zunda/arduino-thermostat/README.md

arduino-thermostat
==================

Trying to replace a broken Differential Temperature Thermostat DTT-94 with an Arduino

太陽熱温水器のサーモスタットが壊れたので代わりのものをつくる

壊れたもの
--------

Differential Temperature Thermostat DTT-94, Heliotrope General

温度計はSAS-10というもののようだ。パネルから温水が戻ってくる配管のタンクの近くにひとつとりつけられている。もうひとつはパネルにとりつけられているものと思われる。回路計では両方とも温度を検出しているような抵抗値を示していた。

温度計の仕様
----------

下記にSAS-10の温度(F)-抵抗のテーブルがある
* http://www.heliodyne.com/products_systems/control_units/SAS-10-RT.pdf
* http://www.heliodyne.com/products_systems/control_units/DeltaT.pdf

これを
[resistance-vs-temperature.xlsx](SAS-10/resistance-vs-temperature.xlsx)
にまとめた。
0℃から100℃までを測定しようとすると、32.65kΩから678.4Ωまでを測定する必要がある。

### 近似式
http://en.wikipedia.org/wiki/Thermistor#Steinhart.E2.80.93Hart_equation
より
```
t(r)=1/(a+b*log(r)+c*(log(r)**3))-273.16
```
ただしrは抵抗値(Ω)、tは温度(℃)。

[resistance-vs-temperature.plot](SAS-10/resistance-vs-temperature.plot)
で0-100℃の範囲を[フィット](SAS-10/fit.log)すると

| Parameter | Best fit (1/K) |
|---|---|
| a | 0.00112974 |
| b | 0.00023399 |
| c | 8.8342e-08 |

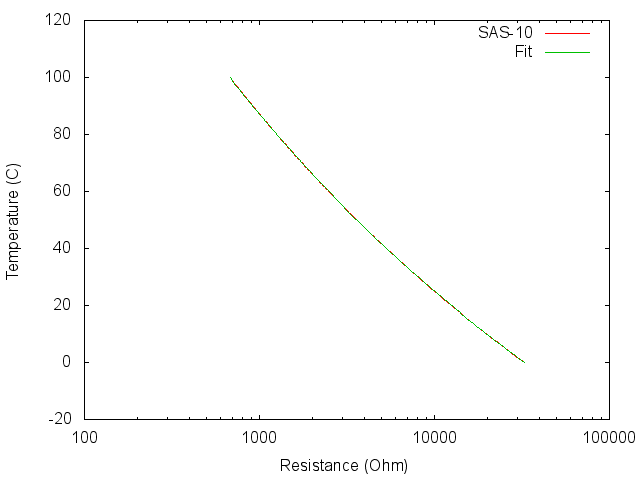
[picture p1: SAS-10/resistance-vs-temperature.png]
resistance-vs-temperature


Arduinoでの抵抗値の読み
--------------------
* `analogRead(pin)`は0から5ボルトの入力電圧を0から1023の数字に変換する
* `analogReference(type)`はアナログ入力で使われる基準電圧を設定する。
  * `DEFAULT`: 電源電圧(5V)
  * `INTERNAL`: 内蔵基準電圧(1.1V、2.56V)
  * `EXTERNAL`: AREFピンへの電圧(0-5V、32KΩでGNDへ)

* http://www.eleki-jack.com/FC/2011/09/arduino2-3.html
  温度計はGNDとアナログ入力の間、アナログ入力と電源の間に固定抵抗
* http://homepage3.nifty.com/sudamiyako/zk/AVR_ADC/AVR_ADC.html
  Sample & Holdコンデンサに注意

分圧抵抗の大きさで分解能が変わるんだねえ。

分圧抵抗の大きさはどの程度が良いか。
Vcc=Vref=5VからR1と温度計Rtを直列にGNDまで接続して、
その接続点の電圧Vadcを読む場合、

```
Vadc = Vref * Rt/(Rt+R1)
```

となる。測定したいRtの範囲がRminからRmaxの場合、
対応する電圧は、

```
Vmin = Vref * Rmin/(Rmin+R1)
Vmax = Vref * Rmax/(Rmax+R1)
```

となる。`Δ = Vmax/Vref - Vmin/Vref` が最大になるとき
`∂Δ/∂R1 = 0`となる。これをR1について解くと、

```
R1 = √(Rmin*Rmax) = 4.7 kΩ
```

となる。分圧抵抗R1は4.7 kΩとするのが良さそう。
このとき、この回路を流れる電流の最大は、`Rt = Rmin = 678.4Ω`のとき
1.1 mA。

Arduino (ATmega328) の注意点
----------------------------
http://www.atmel.com/Images/doc8161.pdf

* [ ] 使っていない入力ピンは消費電力を減らすため内部でプルアップしておくのがシンプル p.80
* [ ] AREFはAD変換器に直接つながっていてGNDとの間をコンデンサでつなぐことで雑音を減らすことができる p.256
* [ ] AVCC近く、GNDとの間に100nF、VCCとの間に10μHをつなぐことで雑音を減らすことができる p.258

MintDuinoでの試験
-----------------
手元に[MintDuino](http://makezine.com/projects/build-a-mintronics-mintduino/)と
[FTDI Friend](http://www.adafruit.com/products/284)
があるのでそれを使う。

### 最小の回路図
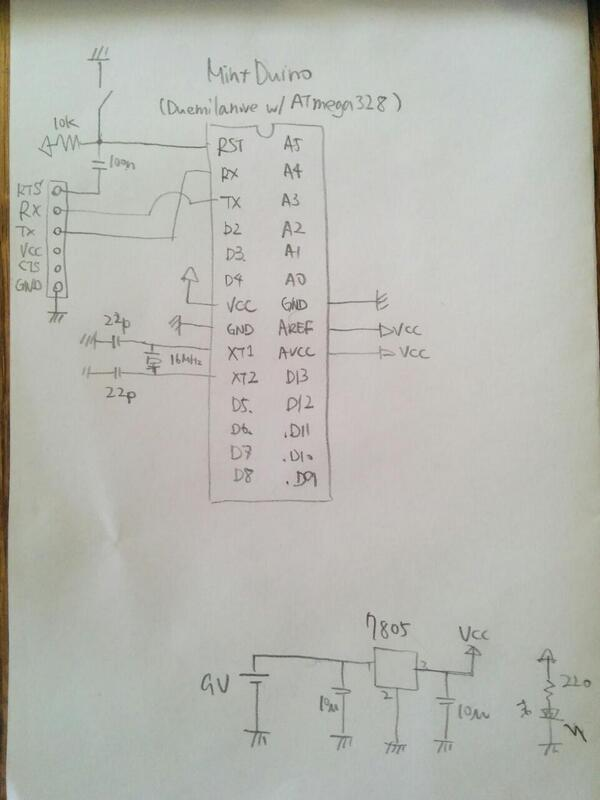
[picture p2: mintduino-minimal.jpg]
Minimal Circuit


### アナログ入力を読んでシリアルポートに出力してみる
Latitude X1のDebianに入れたarduinoパッケージのarduinoコマンドがIDE。
* `Tools`-`Board`-`Arduino Duemilanove w/ ATmega328`
* `Tools`-`Serial Port`-`/dev/ttyUSB0`
* `File`-`Upload (Ctrl+U)` でコンパイル、アップロード、実行
* `Tools`-`Serial Monitor (Ctrl+Shift+M)` でシリアルモニター

`File`-`Examples`-`Basics`-`ReadAnalogVoltage`を改造して(`delay`を加えて)
下記のようにして、モニタを開いたら読めているようだ。

```
/*
  ReadAnalogVoltage
  Reads an analog input on pin 0, converts it to voltage, and prints the result to the serial monitor.
  Attach the center pin of a potentiometer to pin A0, and the outside pins to +5V and ground.

 This example code is in the public domain.
 */

// the setup routine runs once when you press reset:
void setup() {
  // initialize serial communication at 9600 bits per second:
  Serial.begin(9600);
}

// the loop routine runs over and over again forever:
void loop() {
  // read the input on analog pin 0:
  int sensorValue = analogRead(A0);
  // Convert the analog reading (which goes from 0 - 1023) to a voltage (0 - 5V):
  float voltage = sensorValue * (5.0 / 1023.0);
  // print out the value you read:
  Serial.println(voltage);
  delay(100);
}
```

* `delay(100)`で9V電池からの電流は31.5mA。
* `delay(1000)`で9V電池からの電流は28.6mA。

### Cで読む
[read-serial.c](read-serial/read-serial.c) で実験中。

* [ ] [2014-05-25現在](https://github.com/zunda/arduino-thermostat/blob/3682cf5b1333f6444b46643b6de784ea26261bb9/read-serial/read-serial.c)では先方からデータと改行が来ないとプログラムを終えることができない

### 温度計と抵抗を配線して値をしばらく記録してみる
[ReadAdc.ino](ReadAdc/ReadAdc.ino) で実験した。

```
~/local/src/arduino-thermostat/read-serial/read-serial | tee -a ~/tmp/`date +%Y%m%d`.log
```

#### 温度の記録
[20140526.log](ReadAdc/test/20140526.log)

2014-05-26 11:39:27 から始めたログは、
2014-05-27 10:04:08で終わってしまっていた。
9Vの電池が切れたようだ。

* `delay(60000)`
* A0:4.61kΩ+温水タンク直上のSAS-10
* A1:4.65kΩ+太陽熱温水パネル上の、たぶんSAS-10

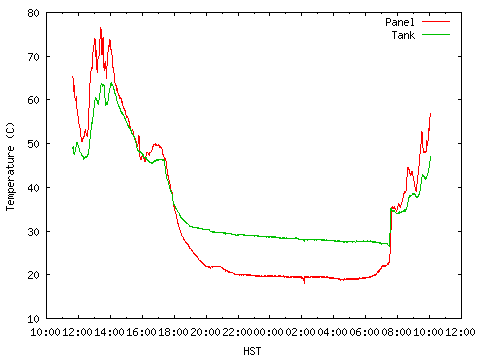
[picture p3: ReadAdc/test/20140526.png]
temperature vs time for 2014-05-26


[20140526.plot](ReadAdc/test/20140526.plot)により、読みを温度に変換したもの。

#### ADCの較正
ブレッドボードでは、ADCからの出力が±30ADUほどずれることがあるようだ。
プリント基板に実装した場合は、ずれは最大-2.3 ADUほどにおさまった。

ブレッドボードに組んだ回路で値を抵抗に変換してみたとろ、
[2014-05-25に](https://github.com/zunda/arduino-thermostat/blob/23d273027570fb3063d9018775317773f0e071a8/Control/Control.ino)
抵抗値を測定した時に、読みにずれが見られた。

このため、ブレッドボードに組んだ回路で
読みのずれを系統的に測定した。ピンA0とA1を4.7kΩ程度の抵抗器でプルアップし、
GNDとの間に10kΩまた100kΩの可変抵抗をとりつけて、
デジボルでピンの電圧を測定しながらADCの結果を読み記録した。

ADCの結果と
それぞれ一連の測定の前に測定したVccとピン電圧から期待されるADCの出力との差は
下図のようになった。

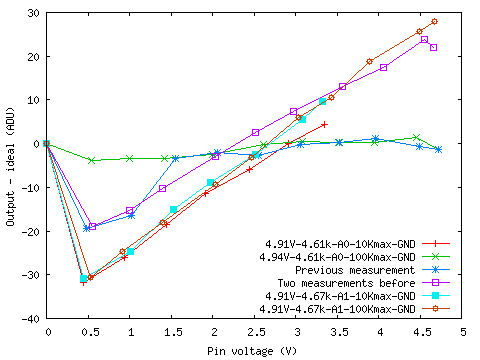
[picture p4: ReadAdc/test/20140615.png]
Output from ADC on 2014-06-15


特にA0に100kΩを接続した場合の測定(紫色)は他の測定と異なる特徴を示したため
2回測定をやりなおしたところ、毎回異なる結果となった(青、緑)。
最後の、精度が良かった測定の際には、他の測定とは異なり、
三端子レギュレータ7805が熱くなっていなかった。
回路あるいは測定系の状態によって、測定精度が変化している可能性がある。

下記の本番機としてプリント基板に実装した回路で測定したところ、
ADCの読みのずれは-2.3 ADUほどにおさまった。

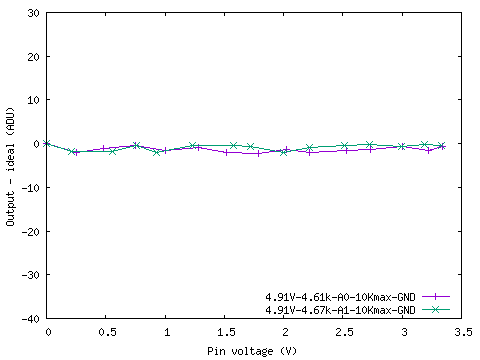
[picture p5: ReadAdc/test/20170611.png]
Output from ADC on 2017-06-11


### 値を抵抗や温度に変換してみる
[Control.ino](Control/Control.ino) で実験中。

本番機
-----
* [回路図](schematic.jpg)
  * 電源、ATmega328周囲のクロック、リセット、シリアルポートは上記、[最小の回路図](#%E6%9C%80%E5%B0%8F%E3%81%AE%E5%9B%9E%E8%B7%AF%E5%9B%B3)を参照
* [実態配線図](pcb-layout.jpg)
  * [RadioshackのPrinted Circuit Board with 780 holes](http://www.radioshack.com/product/index.jsp?productId=2103800)には横に3穴つながったランドが、電源とGNDラインを挟んで5列ある

### 買い物

Radioshcakで揃うか?Amazonに行く必要があるか?電源on/offの制御をする部分がRadioshackには無いな。

* [x] メイン基板 [RadioshackのPrinted Circuit Board with 780 holes](http://www.radioshack.com/product/index.jsp?productId=2103800)
* [x] Arduinoマイコン - MintDuinoからATmega328を流用する
* [x] CR - 手持ちの実験用のものを流用する
* [x] 28ピンのICソケット - 14ピンx2で代用
* 入出力保護 http://www.designer2k2.at/home/arduino/63-arduino-io-protection.html
  * [x] ダイオード4本+2本
  * [x] 22Ω程度の小さい抵抗が2本+1本
  * [x] 100nFか100pF程度のコンデンサが2本+1本
* [ ] 100nFと10μH AVCCの雑音低減
* [x] 100nF AREFの雑音低減
* [x] FTDI friend
* [x] 電源 9Vとか
* [x] 電源コネクタ
* [x] LED表示 電源、データ取得
* [ ] 入力ターミナル - 4端子+2端子
* [ ] 外部とのUSB接続の方法を考える USB-B - USB-miniケーブル?
* [ ] ケース
* 出力リレー - [WeMo Switch](http://www.belkin.com/us/p/P-F7C027/)を利用する

### 実装
#### メイン基板
2014-08-17 3時間程度かかった。
* [表](pcb-front.jpg)
  * アナログ入力のリファレンス抵抗は実測で、A0が4.62kΩ、A1が4.67kΩ
	* デジタル出力には、D10に緑色、D11に黄色のLEDを仮止めした
  * 左にシリアルポートへのピンヘッド (ケーブルで仮止め)
  * AREFの雑音低減に0.1uF
  * レギュレータのパスコンに10uF×2
* [裏](pcb-back.jpg)
  * 入力フィルタ、出力保護に0.1uF×3
  * Arduinoの電源パスコンに0.1uF
  * クロックに22pF×2

## 試験
### パネル側の読みが発振している
2017-06-11

- ADCの誤差は0 - -2.3 ADC程度になった(上記 ADCの較正)
- 定期的に温度を読むようプログラムしてみた: [Measure.ino](https://github.com/zunda/arduino-thermostat/blob/66e8cd3956cde1d78a7b0b17a49afecef31fe98e/Measure/Measure.ino)

- パネル側の温度の読みが発振しているように見える。下記の理由から温度計の配線の寄生容量によるものと思われる
  - ダミーの読み込みとその後のdelayを入れてADCの入力電圧を静定させても見える
  - 入力チャンネルを入れかえると発振しているチャンネルも入れかわる

### パネル側の分圧抵抗に並列にコンデンサを付け発振を抑える
2017-06-17

[それぞれのチャンネルを500 msecずらして1 secごとに読んでみた](https://github.com/zunda/arduino-thermostat/blob/a5ceeb8be57593d53156d0999becbadf57ac6d54/Measure/Measure.ino)ところ、発振の周期は6秒程度だった。

パネル側の分圧抵抗に並列に電解コンデンサを追加した(A0のみ4.7 kΩの抵抗に並列に47 uFの電解コンデンサを追加した)ところ発振が治まった。

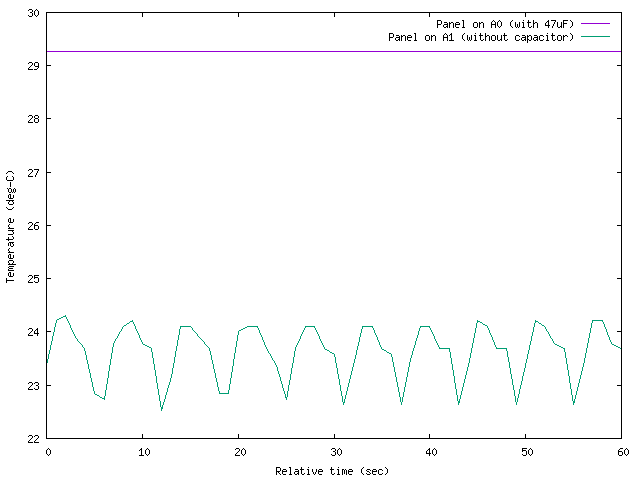
[picture p6: Measure/test/20170617.png]
panel-temp-with-cap


47 uFの電解コンデンサの在庫はもうないため、A1には追加できない。今後は、A0をパネル側の温度計(屋根の上にあり遠い)、A1をタンク側(近い)の温度計の入力として利用する。

一晩のあいだ1秒周期で記録してみたところ、ADU単位の精度で温度が記録できたようだ。

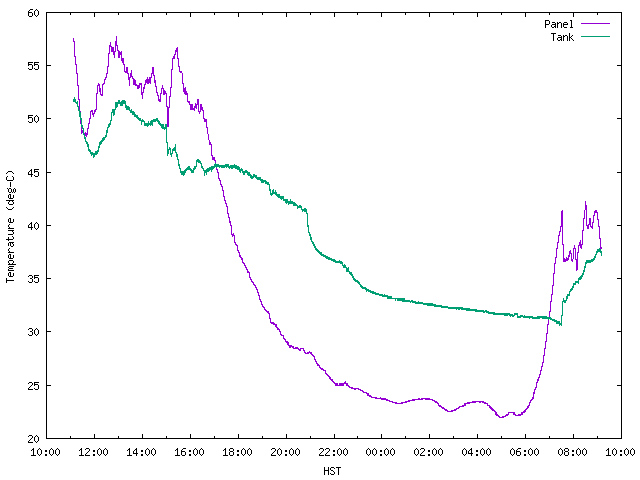
[picture p7: Measure/test/20170618.png]
one-night-measurement
