zunda/arduino-thermostat/pcb-back.jpg

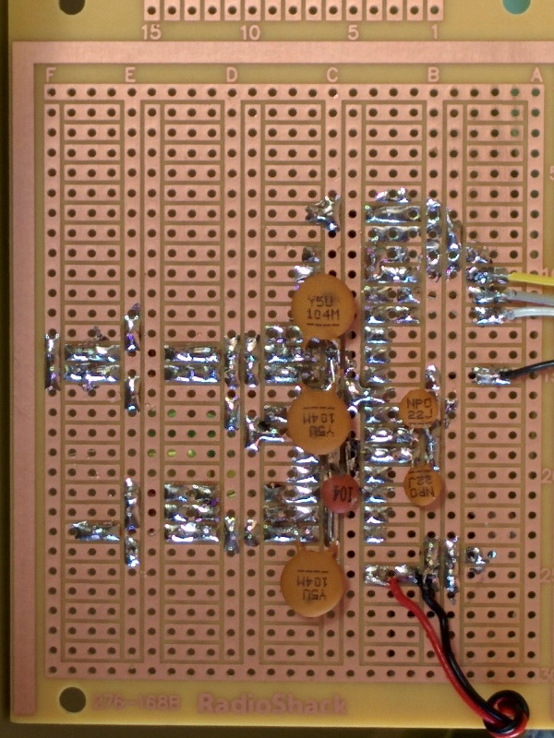
pcb-back.jpg
