zunda/arduino-thermostat/pcb-front.jpg

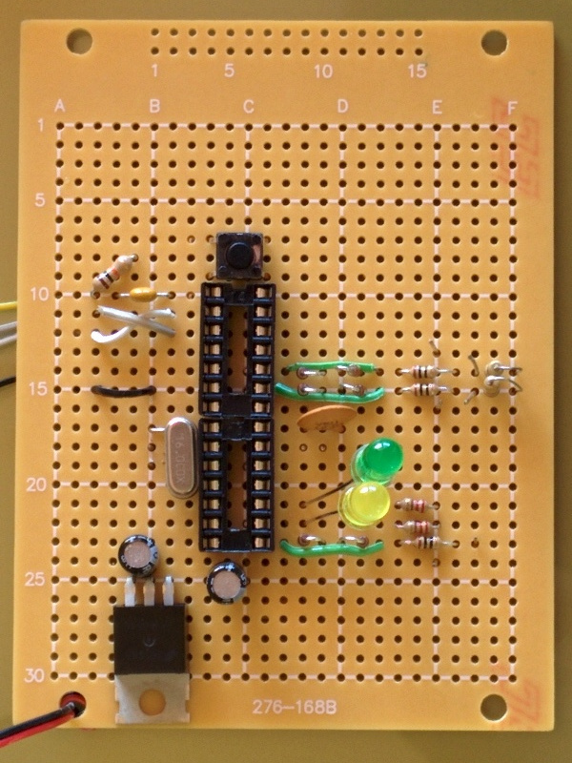
pcb-front.jpg
