zunda/arduino-thermostat/pcb-layout.jpg

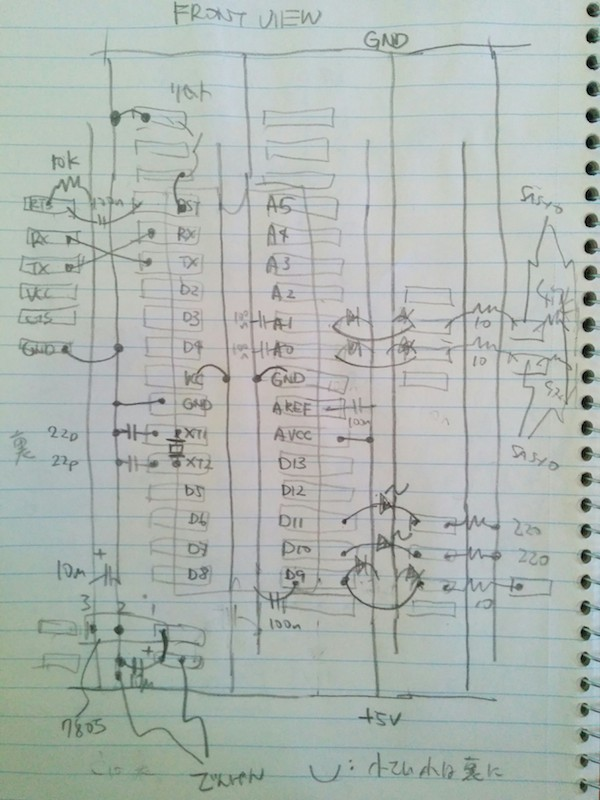
pcb-layout.jpg
