zunda/arduino-thermostat/schematic.jpg

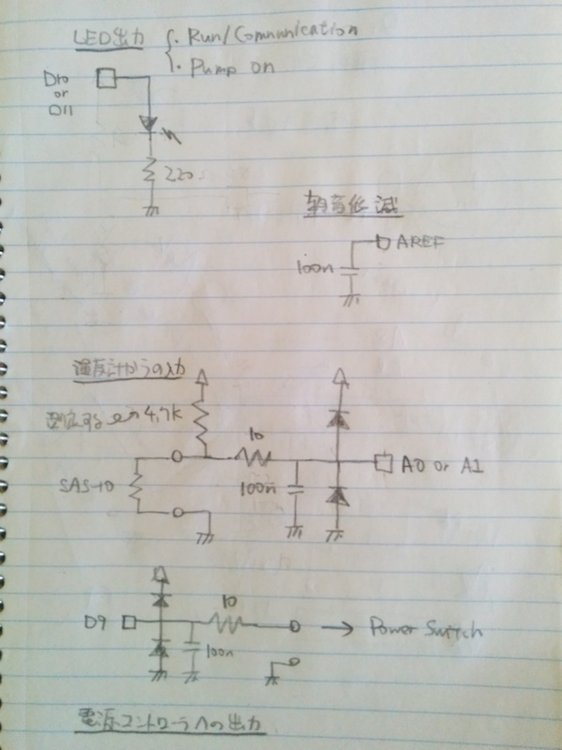
schematic.jpg
