zunda/arduino-thermostat/(commit log)

2014-05-26 Add curve for SAS-10 thermostat
    [resistance-vs-temperature.xlsx]
2014-05-26 Add an Arduino sketch
2014-05-26 Read resistance
2014-05-26 Add decription about converting to resistance
2014-05-26 Read raw ADC values
2014-05-27 Specify temperature range used to fit
2014-05-28 PowerSwitch Tail seems a good choice
2014-05-29 Add a note about additional capacitor on AREF
2014-05-29 Add noise filtering parts to shopping list
2014-05-30 Shop
    They are expensive at Radioshack but handy
    * $ 4.79 2.5mm power jack
    * $23.99 9V 800mA Adaptor + Adaptar plug size N
    * $ 2.39 2x Yello LED
    * $ 2.39 2x Green LED
    * $ 2.99 2x Ceramic capacitor
    * $ 2.99 2x Ceramic capacitor
    * $ 1.79 5x 220 Ohm 1/8W
    * $ 1.79 5x 10 Ohm 1/8W
    * $ 4.19 50x 1N914
    * $ 1.97 Tax
    * $49.28 Total
2014-06-15 Shop
    - $ 1.19 PK2 14 PIN IC SKT 2761999
    - $ 7.09 2.5OZ SOLDER 0.32 640005
    - $ 4.19 UNIV PC BOARD 2760168
    - $12.99 Total
2014-06-16 Make 1Hz sample for checking ADCs
2014-06-16 Measure output from ADC comparing its input voltage
2014-06-16 Plot dADU vs input voltage
    20140615.A0-104.log is away from others.
2014-06-23 Write schematic and design layout on PCB
2014-08-19 Add record for soldering main PCB
2014-08-20 Add description about LEDs on digital outputs
2017-06-12 Calibration on a PCB
2017-06-12 Measure temperature periodically
2017-06-12 Only print line when it is more than 1 byte
2017-06-12 Dummy read ADC for better stability
    [Measure.ino]
2017-06-12 Swithcing wires
2017-06-12 Add one more digit in recording temperature reading
    We are not seeing ADC noise at 0.01 deg-C
    [Measure.ino]
2017-06-18 Measure noise
    Two digits below decimal ponit shuold be enough for an 8-bit ADC
    [Measure.ino]
2017-06-18 Noise test before improvment
    Temperature is high and no noise.
2017-06-18 The data didn't show anything interesting with day time temperature
2017-06-18 Add record for additional capacitor on A0
2017-06-19 Show temperature difference
2017-07-05 Start writing host code
    $ bundle gem arduino_thermostat_host
2017-07-05 WIP: read thermometer on Arduino
2017-07-05 Implement ArduinoThermostatHost::Thermometers.measure
2017-07-05 Implement ArduinoThermostatHost::Pump
